AdriTeixeHax/TFG-Brushless-ESC/Figuras Memoria/gateDriveTransformer.tex

\documentclass[tikz]{standalone}
\usepackage{amsmath}
\usepackage{color,pxfonts,fix-cm}
\usepackage{latexsym}
\usepackage{helvet}
\usepackage{lmodern}
\usepackage{fontspec}
\usepackage[T1]{fontenc}
\usepackage[utf8x]{inputenc}
\usepackage{tgpagella}
\usepackage{pict2e}
\usepackage{wasysym}
\usepackage[english]{babel}
\usepackage{tikz}
\usepackage{circuitikz}
\pagestyle{empty}
\usepackage[margin=1in]{geometry}
\usepackage{pgf}
\usepackage{pgfplots}

% Documento
\begin{document}
\begin{circuitikz}
  \draw (2,0) node[transformer core](T){}
      (T.base) node{1:1}
      (T.inner dot A1) node[circ]{}
      (T.inner dot B1) node[circ]{};
  \draw (T.A1) -- ++(-1,0) coordinate(pt1);
  \draw (T.A2) -- ++(-1,0) to[sqV] (pt1);
  \draw (T.B1) to[R, l={$R_{\textit{G}_\textit{S}}$}] ++(1.5,0) -- ++(0.5,0) node[nigfete, solderdot, anchor=G](Q1){\killdepth{$M_\textit{H}$}};
  \draw (Q1.D) -- ++(0,0.25)node[vcc]{\textit{VDD}};
  \draw (T.B2) -- ++(1.75,0) coordinate(pt2);
  \draw (pt2 |- T.A1) to[R, l_={$R_{\textit{G}_\textit{P}}$}] (pt2);
  \node at (pt2 |- T.A1) [circ] {};
  \draw (pt2) -- (pt2 -| Q1.S) coordinate (pt3) -- (Q1.S);
  \node at (pt2) [circ] {};
  \draw (pt3) -- ++(0.25,0) node[vcc, rotate=-90]{\rotatebox{90}{\!\!\!\!\textit{Carga}}};
  \node at (pt2 -| Q1.S) [circ] {};
  \draw (pt3) node[nigfete, solderdot, anchor=D](Q2){$M_\textit{L}$};
  \draw[dashed] (Q2.S) -- ++(0,-0.5);
  \draw[dashed] (Q2.G) -- ++(-0.5,0);
\end{circuitikz}
\end{document}
