AdriTeixeHax/TFG-Brushless-ESC/Figuras Memoria/diseñoGeneralESC.pdf

LDO

+5 V | +3.3 V | +24 V | LDO | +12 V

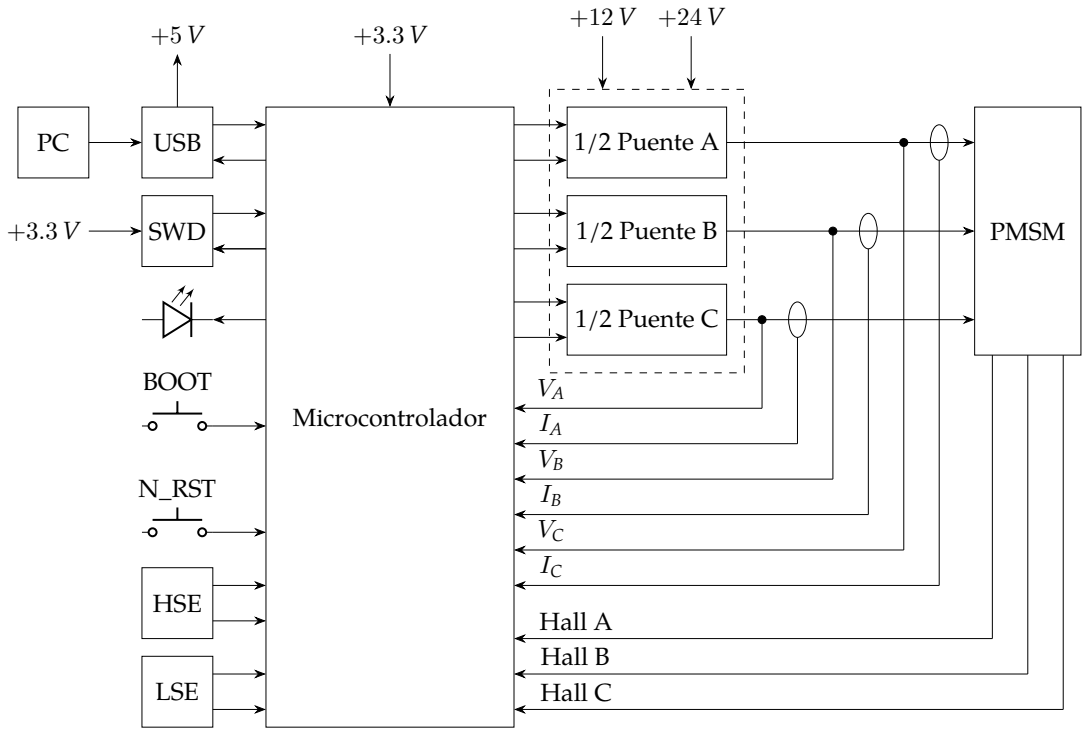
[picture p1: figure]
1/2 Puente A; 1/2 Puente B; 1/2 Puente C; Microcontrolador; Hall A Hall B Hall C; USB; PMSM; HSE; LSE; SWD; BOOT; N_RST
