AdriTeixeHax/TFG-Brushless-ESC/Figuras Memoria/gateDriveTransformer.pdf

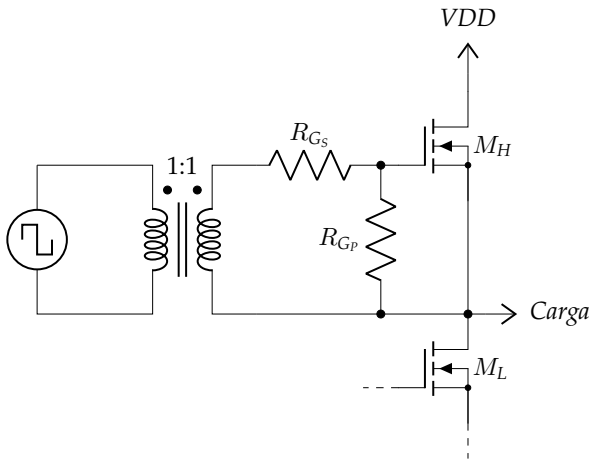
[picture p2: figure]
RGS; VDD; RGP; Carga
