AdriTeixeHax/TFG-Brushless-ESC/Figuras Memoria/insideMOSFET.pdf

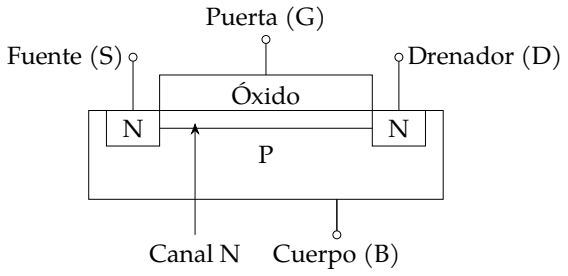
[picture p3: figure]
Óxido; Canal N; Fuente (S); Drenador (D); Puerta (G); Cuerpo (B)

G
S

D
