AdriTeixeHax/TFG-Brushless-ESC/Figuras Memoria/PCBStructure.pdf

Serigrafía inferior

Máscara de soldadura inferior

Cobre inferior

Prepreg (Fibra de vidrio + resina)

Cobre interna 2

Fibra de vidrio (FR4)

Cobre interna 1

Prepreg (Fibra de vidrio + resina)

Cobre superior

Máscara de soldadura superior

Serigrafía superior
