AdriTeixeHax/TFG-Brushless-ESC/Figuras Memoria/phaseEq.pdf

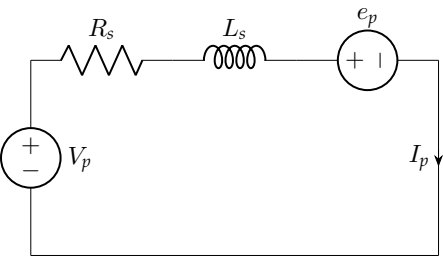
[picture p4: figure]
VpR
