AdriTeixeHax/TFG-Brushless-ESC/Figuras Memoria/boostConverterOperation.tex

\documentclass[tikz]{standalone}
\usepackage{amsmath}
\usepackage{color,pxfonts,fix-cm}
\usepackage{latexsym}
\usepackage{helvet}
\usepackage{lmodern}
\usepackage{fontspec}
\usepackage[T1]{fontenc}
\usepackage[utf8x]{inputenc}
\usepackage{tgpagella}
\usepackage{pict2e}
\usepackage{wasysym}
\usepackage[english]{babel}
\usepackage{tikz}
\usepackage{circuitikz}
\pagestyle{empty}
\usepackage[margin=1in]{geometry}
\usepackage{pgf}
\usepackage{pgfplots}

% Documento
\begin{document}
    \pgfplotsset{yticklabel style={text width=6em,align=right}}
    \centering
    \begin{tikzpicture}[scale=0.9]
        \begin{axis}[
            title={\textit{PWM}},
            grid=major,
            width=10cm,
            height=3.8cm,
            ymin=-0.2, ymax=1.2,
            xmin=0, xmax=10,
            xtick={0,2,4,6,8,10},
            xticklabels={$0$, $DT$, $T$, $T+DT$, $2T$, $2T+DT$},
            ytick={0,1},
            yticklabels={\textit{OFF}, \textit{ON}},
            samples=1000,
            at={(0,0cm)}
        ]
            \addplot [
                domain=0:10,
                samples=1000,
                blue,
            ]
            {
                (x < 2 || (x > 4 && x < 6) || (x > 8 && x < 10)) ? 1 : 0
            };
        \end{axis}
        \begin{axis}[
            title={$v_\textit{L}(t)$},
            grid=major,
            width=10cm,
            height=3.8cm,
            ymin=-7, ymax=12,
            xmin=0, xmax=10,
            xtick={0,2,4,6,8,10},
            xticklabels={$0$, $DT$, $T$, $T+DT$, $2T$, $2T+DT$},
            ytick={-5,0,10},
            yticklabels={$V_{\textit{out}} - V_{\textit{in}}$, $0$, $V_\textit{in}$},
            samples=1000,
            at={(0,-3.75cm)}
        ]
            \addplot [
                domain=0:10,
                samples=1000,
                blue,
            ]
            {
                (x < 2 || (x > 4 && x < 6) || (x > 8 && x < 10)) ? 10 : -5
            };
        \end{axis}
        \begin{axis}[
            title={$i_\textit{L}(t)$},
            grid=major,
            width=10cm,
            height=3.8cm,
            ymin=0, ymax=10,
            xmin=0, xmax=10,
            xtick={0,2,4,6,8,10},
            xticklabels={$0$, $DT$, $T$, $T+DT$, $2T$, $2T+DT$},
            ytick={5,9},
            yticklabels={$I_\textit{in}$, $I_\textit{in} + \Delta i_\textit{L}$},
            at={(0,-7.5cm)}
        ]
        \addplot [color=blue, forget plot]
          table[row sep=crcr]{%
            0	5\\
            2	8.98\\
            4	4.96\\
            6	8.94\\
            8	4.92\\
            10	8.9\\
        };
        \end{axis}
        \begin{axis}[
            title={$i_{\textit{SW}}(t)$},
            grid=major,
            width=10cm,
            height=3.8cm,
            ymin=0, ymax=10,
            xmin=0, xmax=10,
            xtick={0,2,4,6,8,10},
            xticklabels={$0$, $DT$, $T$, $T+DT$, $2T$, $2T+DT$},
            ytick={5,9},
            yticklabels={$I_\textit{SW}$, $I_\textit{SW}^\textit{p}$},
            at={(0,-11.25cm)}
        ]
        \addplot [color=blue, forget plot]
          table[row sep=crcr]{%
            0	5\\
            0.01	5.02\\
            0.02	5.04\\
            0.03	5.06\\
            0.04	5.08\\
            0.05	5.1\\
            0.06	5.12\\
            0.07	5.14\\
            0.08	5.16\\
            0.09	5.18\\
            0.1	5.2\\
            0.11	5.22\\
            0.12	5.23999999999999\\
            0.13	5.25999999999999\\
            0.14	5.27999999999999\\
            0.15	5.29999999999999\\
            0.16	5.31999999999999\\
            0.17	5.33999999999999\\
            0.18	5.35999999999999\\
            0.19	5.37999999999999\\
            0.2	5.39999999999999\\
            0.21	5.41999999999999\\
            0.22	5.43999999999999\\
            0.23	5.45999999999999\\
            0.24	5.47999999999999\\
            0.25	5.49999999999999\\
            0.26	5.51999999999999\\
            0.27	5.53999999999999\\
            0.28	5.55999999999999\\
            0.29	5.57999999999999\\
            0.3	5.59999999999999\\
            0.31	5.61999999999999\\
            0.32	5.63999999999999\\
            0.33	5.65999999999999\\
            0.34	5.67999999999999\\
            0.35	5.69999999999999\\
            0.36	5.71999999999998\\
            0.37	5.73999999999998\\
            0.38	5.75999999999998\\
            0.39	5.77999999999998\\
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
        };
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
                0.25	-1\\
                0.26	-1\\
                0.27	-1\\
                0.28	-1\\
                0.29	-1\\
                0.3	-1\\
                0.31	-1\\
                0.32	-1\\
                0.33	-1\\
                0.34	-1\\
                0.35	-1\\
                0.36	-1\\
                0.37	-1\\
                0.38	-1\\
                0.39	-1\\
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
            };
        \end{axis}
    \end{tikzpicture}%  
\end{document}
