AdriTeixeHax/TFG-Brushless-ESC/Figuras Memoria/boostConverterOperation.pdf

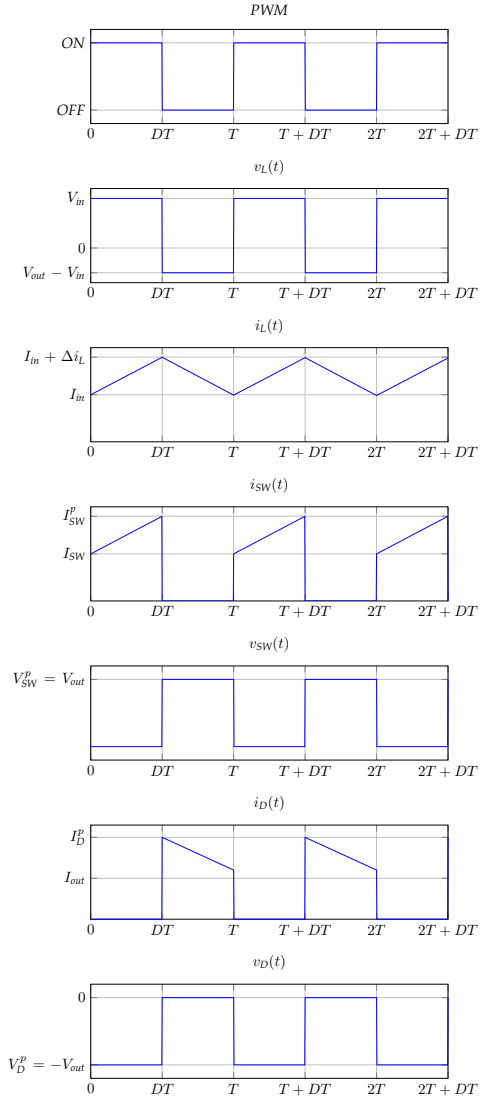
[picture p5: page 1]
OFF; PWM; Vout − Vin; Vin; Iin; Iin + ∆iL; ISW; iSW(t); p SW = Vout; vSW(t); Iout; p D = −Vout
