AdriTeixeHax/TFG-Brushless-ESC/Figuras Memoria/controlledHB.pdf

# VCCCOM

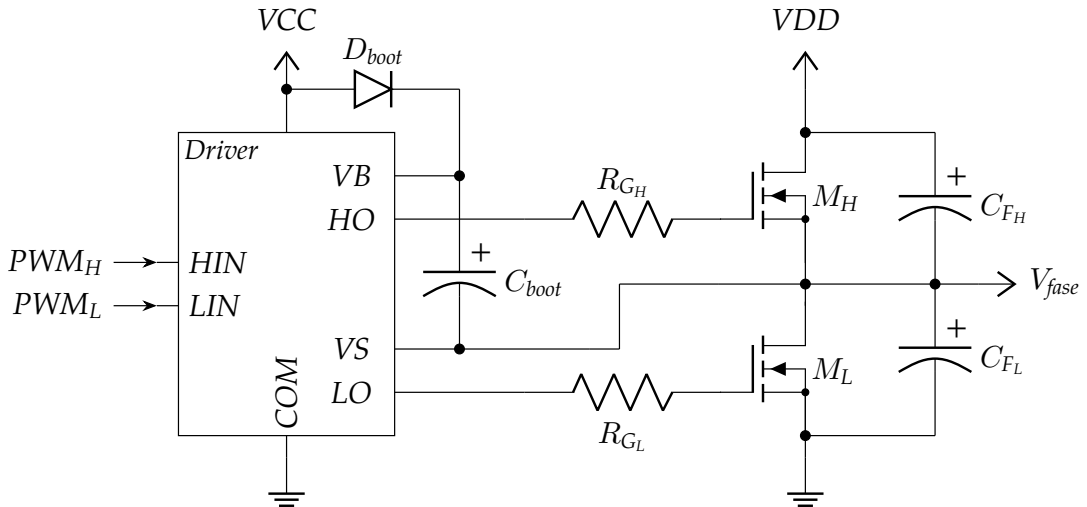
[picture p6: page 1]
Dboot; Cboot; HIN LIN; Vfase; PWM; H PWM; VDD; Driver
