AdriTeixeHax/TFG-Brushless-ESC/Figuras Memoria/curvesMOSFET.pdf

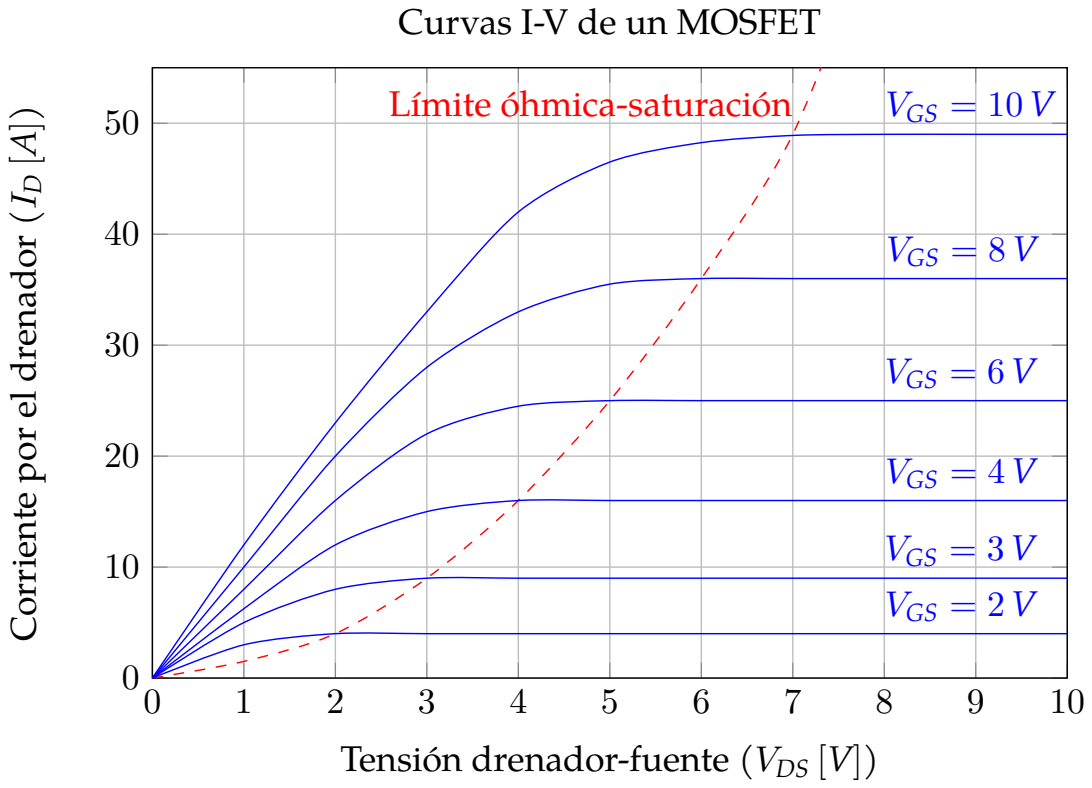
[picture p7: page 1]
Límite óhmica-saturación; VGS =; VDS

Curvas I-V de un MOSFET

Corriente por el drenador (ID [A])

VGS = | 8 V

VGS = | 6 V

VGS = | V 4 3 V

VGS = | 2 V

Tensión drenador-fuente (
