AdriTeixeHax/TFG-Brushless-ESC/Figuras Memoria/boostConverter.pdf

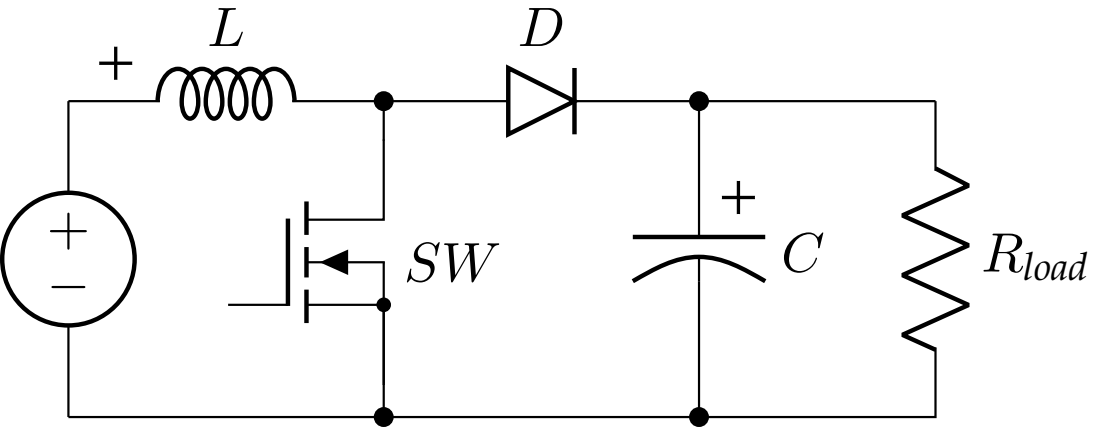
[picture p8: page 1]
Rload
