AdriTeixeHax/TFG-Brushless-ESC/Figuras Memoria/fullBridge.pdf

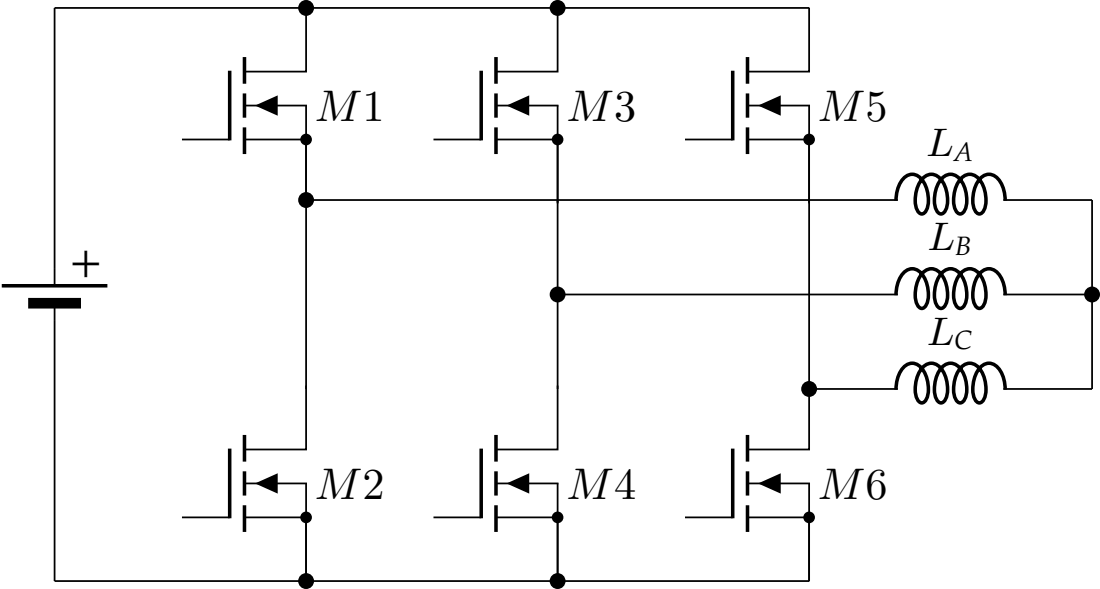
[picture p9: page 1]
