AdriTeixeHax/TFG-Brushless-ESC/Figuras Memoria/ringing.pdf

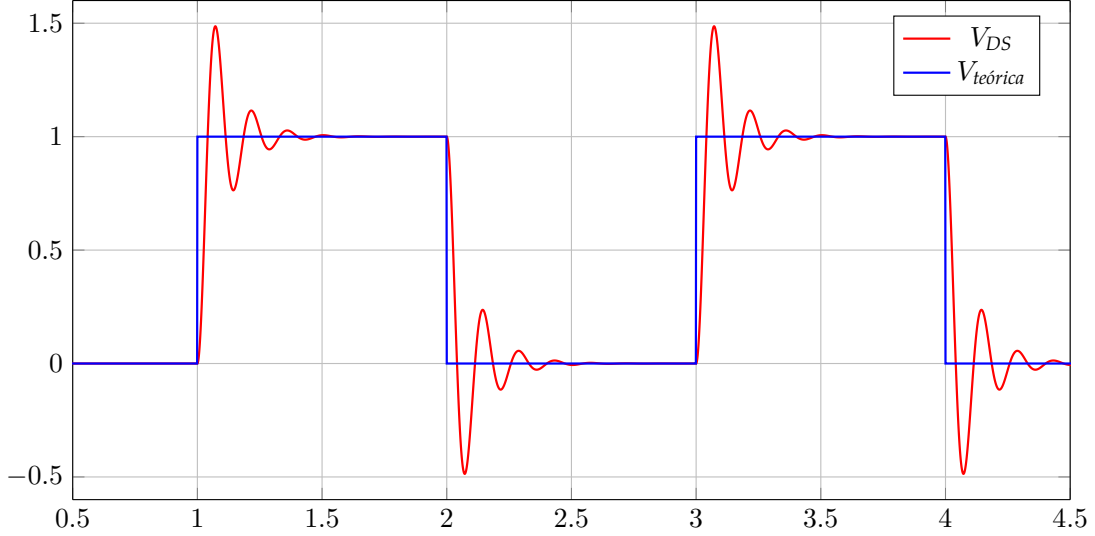
[picture p10: page 1]
VDS Vteórica
