AdriTeixeHax/TFG-Brushless-ESC/simulation/models/LT1160_TA01.asc

C1: cap; 10µ
C2: cap; 1µ
C3: cap; 100µ
D1: diode; 1N4148
Lload: ind; .7m; Rser=.16
Q1: nmos; IRFZ44N
Q2: nmos; IRFZ44N
R1: res; 10K
U1: LT1160
V1: voltage; 12
V2: voltage; PULSE(0 3.3 0; 1n 1n 1u 10u)
V3: voltage; PULSE(0 3.3 5u; 1n 1n 1u 10u)
V4: voltage; 24
Named nets: 0, IN, OUT
.tran 1m startup
LT1160 - Half-/Full-Bridge N-Channel Power MOSFET Drivers
60V Max Supply Referenced DC Motor Half-Bridge Driver
Note:
  If the simulation model is not found please update with the "Sync Release" command from the "Tools" menu.
  It remains the customer's responsibility to verify proper and reliable operation in the actual application.
  Component substitution and printed circuit board layout may significantly affect circuit performance or reliability.
  Contact your local sales representative for assistance. This circuit is distributed to customers only for use with LTC parts.
  Copyright © 2012 Linear Technology Inc. All rights reserved.
