AdriTeixeHax/TFG-Brushless-ESC/TFG-Brushless-ESC/TFG-Brushless-ESC.kicad_pcb

## KiCad design TFG-Brushless-ESC/TFG-Brushless-ESC.kicad_pcb (2025-02-09)

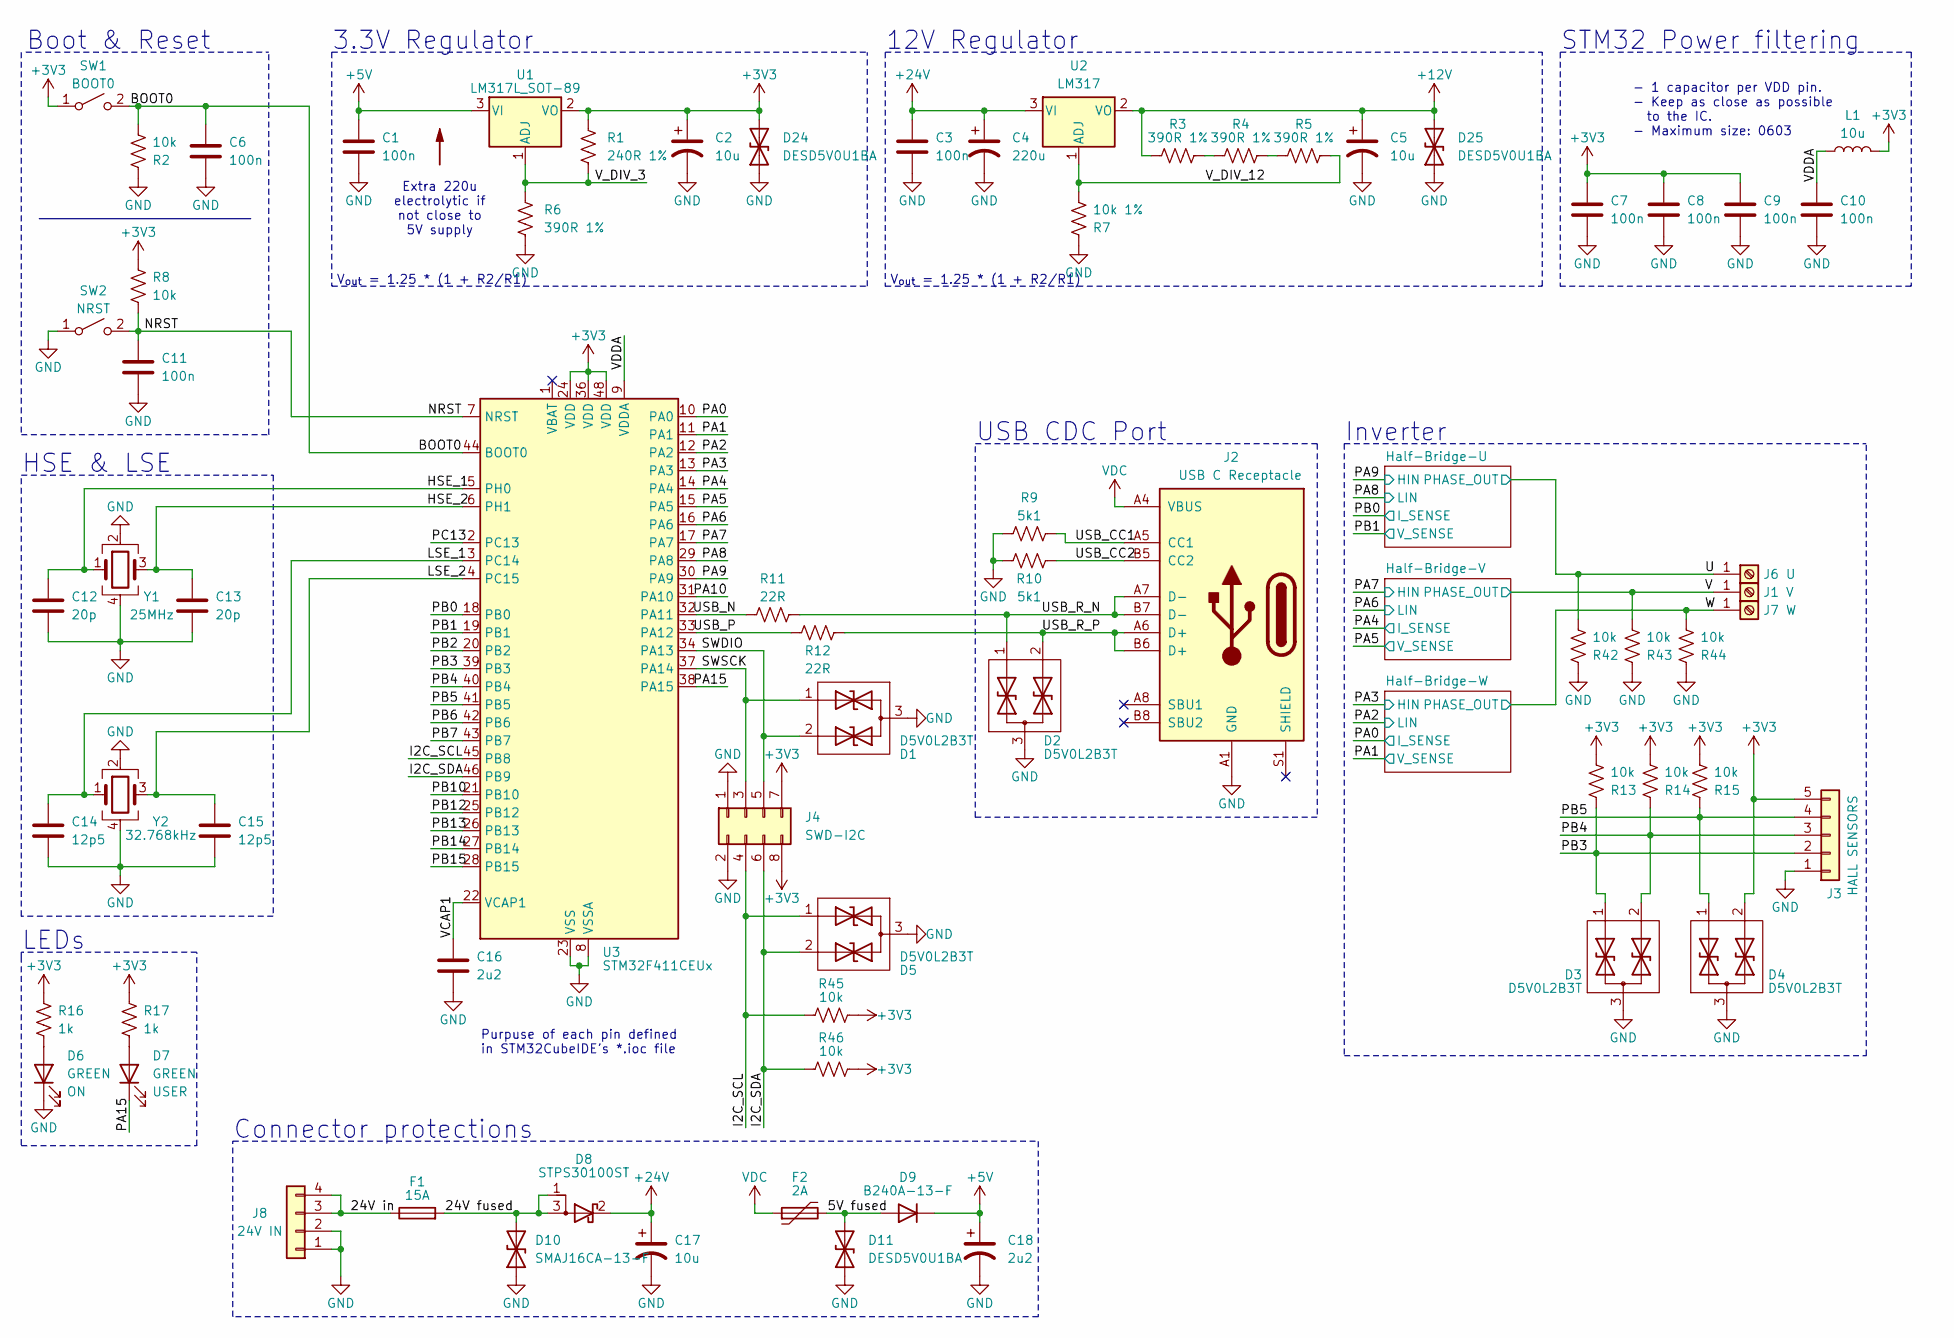
[picture p11: schematic TFG-Brushless-ESC.kicad_sch, RTSpeed]

Parts:
C1, C3, C6, C7, C8, C9, C10, C11: 100n; C_0603_1608Metric
C2, C5, C17: 10u; CP_Elec_4x5.4
C4: 220u; CP_Elec_4x5.4
C12, C13: 20p; C_0603_1608Metric
C14, C15: 12p5; C_0603_1608Metric
C16: 2u2; C_0603_1608Metric
C18: 2u2; CP_Elec_4x5.4
D1, D2, D3, D4, D5: D5V0L2B3T; SOT-523
D6, D7: GREEN; LED_0805_2012Metric
D8: STPS30100ST; TO-220-3_Vertical
D9: B240A-13-F; D_SMA
D10: SMAJ16CA-13-F; D_SMA
D11, D24, D25: DESD5V0U1BA; D_SOD-323_HandSoldering
F1: 15A; Fuseholder_Automotive
F2: 2A; Fuse_1812_4532Metric
J1: V; Screw_Terminal; LCSC part C481447
J2: USB C Receptacle; USB_C_Receptacle_XKB_U262-16XN-4BVC11
J3: HALL SENSORS; JST_PH_S5B-PH-K_1x05_P2.00mm_Horizontal
J4: SWD-I2C; PinHeader_2x04_P2.54mm_Horizontal
J6: U; Screw_Terminal; LCSC part C481447
J7: W; Screw_Terminal; LCSC part C481447
J8: 24V IN; PhoenixContact_MSTBA_2,5_4-G-5,08_1x04_P5.08mm_Horizontal
L1: 10u; L_0805_2012Metric
R1: 240R 1%; R_0603_1608Metric
R2, R8, R13, R14, R15, R42, R43, R44, R45, R46: 10k; R_0603_1608Metric
R3, R4, R5, R6: 390R 1%; R_0603_1608Metric
R7: 10k 1%; R_0603_1608Metric
R9, R10: 5k1; R_0603_1608Metric
R11, R12: 22R; R_0603_1608Metric
R16, R17: 1k; R_0603_1608Metric
SW1: BOOT0; SW_Push_1P1T_NO_6x6mm_H9.5mm
SW2: NRST; SW_Push_1P1T_NO_6x6mm_H9.5mm
U1: LM317L_SOT-89; SOT-89-3
U2: LM317; TO-220-3_Vertical
U3: STM32F411CEUx; QFN-48-1EP_7x7mm_P0.5mm_EP5.6x5.6mm
Y1: 25MHz; Oscillator_SMD_Abracon_ASE-4Pin_3.2x2.5mm
Y2: 32.768kHz; Oscillator_SMD_Abracon_ASE-4Pin_3.2x2.5mm

Connections:
+3V3: C2.1, C7.1, C8.1, C9.1, D4.2, D24.2 (A2), J3.5, J4.7, J4.8, L1.2, R1.1, R8.1, R13.2, R14.2, R15.2, R16.1, R17.1, R45.2, R46.2, SW1.1 (A), U1.2 (VO), U3.24 (VDD), U3.36 (VDD), U3.48 (VDD); also elsewhere on the board
+5V: C1.1, C18.1, D9.1 (K), U1.3 (VI)
+12V: C5.1, D25.2 (A2), R3.1, U2.2 (VO); also elsewhere on the board
+24V: C3.1, C4.1, C17.1, D8.2 (K), U2.3 (VI); also elsewhere on the board
/5V fused: D9.2 (A), D11.2 (A2), F2.2
/24V fused: D8.1 (A), D8.3 (A), D10.2 (A2), F1.2
/24V in: F1.1, J8.3, J8.4; also elsewhere on the board
/BOOT0: C6.2, R2.2, SW1.2 (B), U3.44 (BOOT0)
/HSE_1: C12.1, U3.5 (PH0), Y1.1
/HSE_2: C13.1, U3.6 (PH1), Y1.3
/I2C_SCL: D5.1, J4.4, R45.1, U3.45 (PB8)
/I2C_SDA: D5.2, J4.6, R46.1, U3.46 (PB9)
/LSE_1: C14.1, U3.3 (PC14), Y2.1
/LSE_2: C15.1, U3.4 (PC15), Y2.3
/NRST: C11.2, R8.2, SW2.2 (B), U3.7 (NRST)
/PA0: U3.10 (PA0); also elsewhere on the board
/PA1: U3.11 (PA1); also elsewhere on the board
/PA2: U3.12 (PA2); also elsewhere on the board
/PA3: U3.13 (PA3); also elsewhere on the board
/PA4: U3.14 (PA4); also elsewhere on the board
/PA5: U3.15 (PA5); also elsewhere on the board
/PA6: U3.16 (PA6); also elsewhere on the board
/PA7: U3.17 (PA7); also elsewhere on the board
/PA8: U3.29 (PA8); also elsewhere on the board
/PA9: U3.30 (PA9); also elsewhere on the board
/PA10: U3.31 (PA10)
/PA15: D7.1 (K), U3.38 (PA15)
/PB0: U3.18 (PB0); also elsewhere on the board
/PB1: U3.19 (PB1); also elsewhere on the board
/PB2: U3.20 (PB2)
/PB3: D3.1, J3.2, R13.1, U3.39 (PB3)
/PB4: D3.2, J3.3, R14.1, U3.40 (PB4)
/PB5: D4.1, J3.4, R15.1, U3.41 (PB5)
/PB6: U3.42 (PB6)
/PB7: U3.43 (PB7)
/PB10: U3.21 (PB10)
/PB12: U3.25 (PB12)
/PB13: U3.26 (PB13)
/PB14: U3.27 (PB14)
/PB15: U3.28 (PB15)
/PC13: U3.2 (PC13)
/SWDIO: D1.2, J4.5, U3.34 (PA13)
/SWSCK: D1.1, J4.3, U3.37 (PA14)
/U: J6.1, R42.2; also elsewhere on the board
/USB_CC1: J2.A5 (CC1), R9.2
/USB_CC2: J2.B5 (CC2), R10.2
/USB_N: R11.1, U3.32 (PA11)
/USB_P: R12.1, U3.33 (PA12)
/USB_R_N: D2.1, J2.A7 (D-), J2.B7 (D-), R11.2
/USB_R_P: D2.2, J2.A6 (D+), J2.B6 (D+), R12.2
/V: J1.1, R43.2; also elsewhere on the board
/VCAP1: C16.1, U3.22 (VCAP1)
/VDDA: C10.1, L1.1, U3.9 (VDDA)
/V_DIV_3: R1.2, R6.1, U1.1 (ADJ)
/V_DIV_12: R5.2, R7.2, U2.1 (ADJ)
/W: J7.1, R44.2; also elsewhere on the board
GND: C1.2, C2.2, C3.2, C4.2, C5.2, C6.1, C7.2, C8.2, C9.2, C10.2, C11.1, C12.2, C13.2, C14.2, C15.2, C16.2, C17.2, C18.2, D1.3, D2.3, D3.3, D4.3, D5.3, D6.1 (K), D10.1 (A1), D11.1 (A1), D24.1 (A1), D25.1 (A1), J2.A1 (GND), J2.A12 (GND), J2.B1 (GND), J2.B12 (GND), J3.1, J4.1, J4.2, J8.1, J8.2, R2.1, R6.2, R7.1, R9.1, R10.1, R42.1, R43.1, R44.1, SW2.1 (A), U3.8 (VSSA), U3.23 (VSS), U3.35 (VSS), U3.47 (VSS), U3.49 (VSS), Y1.2, Y1.4, Y2.2, Y2.4; also elsewhere on the board
unnamed: D6.2 (A), R16.2
unnamed: D7.2 (A), R17.2
unnamed: R3.2, R4.1
unnamed: R4.2, R5.1
VDC: F2.1, J2.A4 (VBUS), J2.A9 (VBUS), J2.B4 (VBUS), J2.B9 (VBUS)

Notes on the sheet:
V_{out} = 1.25 * (1 + R2/R1)
Boot & Reset
LEDs
3.3V Regulator
STM32 Power filtering
Connector protections
- 1 capacitor per VDD pin. - Keep as close as possible to the IC. - Maximum size: 0603
Inverter
USB CDC Port
12V Regulator
HSE & LSE
Purpuse of each pin defined in STM32CubeIDE's *.ioc file
Extra 220u electrolytic if not close to 5V supply

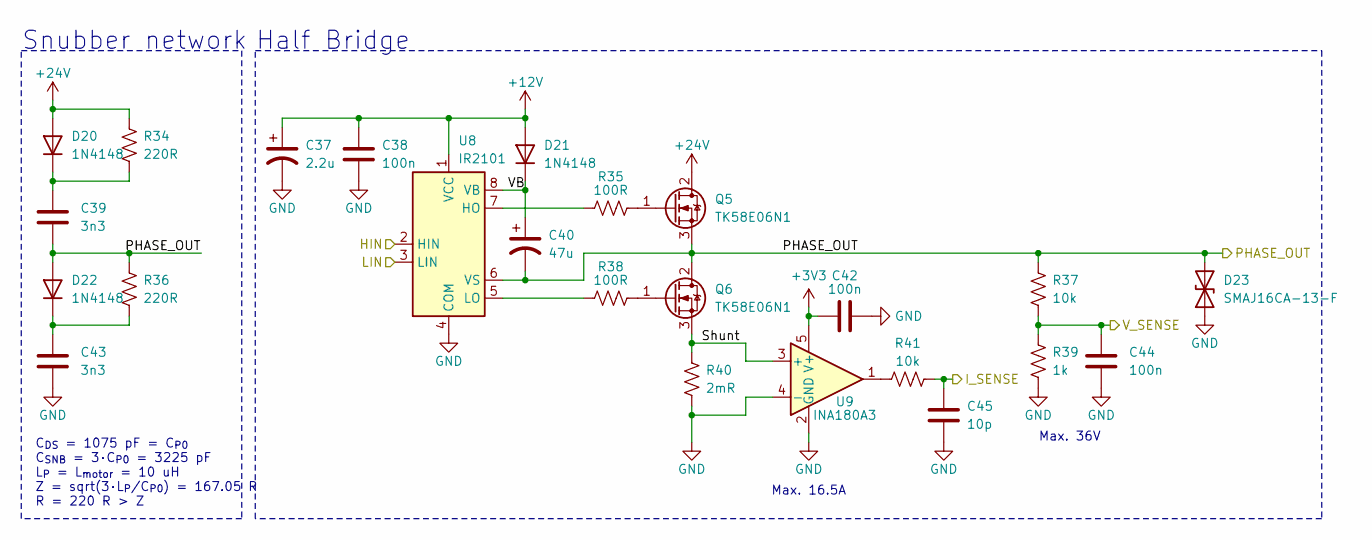
[picture p12: schematic Half-Bridge.kicad_sch, Half Bridge]

Parts:
C37: 2.2u; CP_Elec_4x5.4
C38, C42, C44: 100n; C_0603_1608Metric
C39, C43: 3n3; C_0603_1608Metric
C40: 47u; CP_Elec_4x5.4
C45: 10p; C_0603_1608Metric
D20, D21, D22: 1N4148; D_SOD-123
D23: SMAJ16CA-13-F; D_SMA
Q5, Q6: TK58E06N1; TO-220-3_Vertical
R34, R36: 220R; R_0603_1608Metric
R35, R38: 100R; R_0805_2012Metric
R37, R41: 10k; R_0603_1608Metric
R39: 1k; R_0603_1608Metric
R40: 2mR; R_2512_6332Metric
U8: IR2101; SOIC-8-1EP_3.9x4.9mm_P1.27mm_EP2.29x3mm
U9: INA180A3; SOT-23-5

Connections:
+3V3: C42.1, U9.5 (V+); also elsewhere on the board
+12V: C37.1, C38.1, D21.2 (A), U8.1 (VCC); also elsewhere on the board
+24V: D20.2 (A), Q5.2 (D), R34.2; also elsewhere on the board
/Half-Bridge-W/Shunt: Q6.3 (S), R40.1, U9.3 (+)
/Half-Bridge-W/VB: C40.1, D21.1 (K), U8.8 (VB)
/PA0: C45.2, R41.2; also elsewhere on the board
/PA1: C44.1, R37.1, R39.2; also elsewhere on the board
/PA2: U8.3 (LIN); also elsewhere on the board
/PA3: U8.2 (HIN); also elsewhere on the board
/W: C39.2, C40.2, D22.2 (A), D23.2 (A2), Q5.3 (S), Q6.2 (D), R36.2, R37.2, U8.6 (VS); also elsewhere on the board
GND: C37.2, C38.2, C42.2, C43.2, C44.2, C45.1, D23.1 (A1), R39.1, R40.2, U8.4 (COM), U9.2 (GND), U9.4 (-); also elsewhere on the board
unnamed: C39.1, D20.1 (K), R34.1
unnamed: C43.1, D22.1 (K), R36.1
unnamed: Q5.1 (G), R35.2
unnamed: Q6.1 (G), R38.2
unnamed: R41.1, U9.1
unnamed: R35.1, U8.7 (HO)
unnamed: R38.1, U8.5 (LO)

Parts of its further copies:
C19, C28: 2.2u; CP_Elec_4x5.4
C20, C24, C26, C29, C33, C35: 100n; C_0603_1608Metric
C21, C25, C30, C34: 3n3; C_0603_1608Metric
C22, C31: 47u; CP_Elec_4x5.4
C27, C36: 10p; C_0603_1608Metric
D12, D13, D14, D16, D17, D18: 1N4148; D_SOD-123
D15, D19: SMAJ16CA-13-F; D_SMA
Q1, Q2, Q3, Q4: TK58E06N1; TO-220-3_Vertical
R18, R20, R26, R28: 220R; R_0603_1608Metric
R19, R22, R27, R30: 100R; R_0805_2012Metric
R21, R25, R29, R33: 10k; R_0603_1608Metric
R23, R31: 1k; R_0603_1608Metric
R24, R32: 2mR; R_2512_6332Metric
U4, U6: IR2101; SOIC-8-1EP_3.9x4.9mm_P1.27mm_EP2.29x3mm
U5, U7: INA180A3; SOT-23-5

Connections of its further copies:
+3V3: C24.1, C33.1, U5.5 (V+), U7.5 (V+); also elsewhere on the board
+12V: C19.1, C20.1, C28.1, C29.1, D13.2 (A), D17.2 (A), U4.1 (VCC), U6.1 (VCC); also elsewhere on the board
+24V: D12.2 (A), D16.2 (A), Q1.2 (D), Q3.2 (D), R18.2, R26.2; also elsewhere on the board
/Half-Bridge-U/Shunt: Q2.3 (S), R24.1, U5.3 (+)
/Half-Bridge-U/VB: C22.1, D13.1 (K), U4.8 (VB)
/Half-Bridge-V/Shunt: Q4.3 (S), R32.1, U7.3 (+)
/Half-Bridge-V/VB: C31.1, D17.1 (K), U6.8 (VB)
/PA4: C36.2, R33.2; also elsewhere on the board
/PA5: C35.1, R29.1, R31.2; also elsewhere on the board
/PA6: U6.3 (LIN); also elsewhere on the board
/PA7: U6.2 (HIN); also elsewhere on the board
/PA8: U4.3 (LIN); also elsewhere on the board
/PA9: U4.2 (HIN); also elsewhere on the board
/PB0: C27.2, R25.2; also elsewhere on the board
/PB1: C26.1, R21.1, R23.2; also elsewhere on the board
/U: C21.2, C22.2, D14.2 (A), D15.2 (A2), Q1.3 (S), Q2.2 (D), R20.2, R21.2, U4.6 (VS); also elsewhere on the board
/V: C30.2, C31.2, D18.2 (A), D19.2 (A2), Q3.3 (S), Q4.2 (D), R28.2, R29.2, U6.6 (VS); also elsewhere on the board
GND: C19.2, C20.2, C24.2, C25.2, C26.2, C27.1, C28.2, C29.2, C33.2, C34.2, C35.2, C36.1, D15.1 (A1), D19.1 (A1), R23.1, R24.2, R31.1, R32.2, U4.4 (COM), U5.2 (GND), U5.4 (-), U6.4 (COM), U7.2 (GND), U7.4 (-); also elsewhere on the board
unnamed: C21.1, D12.1 (K), R18.1
unnamed: C25.1, D14.1 (K), R20.1
unnamed: C30.1, D16.1 (K), R26.1
unnamed: C34.1, D18.1 (K), R28.1
unnamed: Q1.1 (G), R19.2
unnamed: Q2.1 (G), R22.2
unnamed: Q3.1 (G), R27.2
unnamed: Q4.1 (G), R30.2
unnamed: R25.1, U5.1
unnamed: R33.1, U7.1
unnamed: R19.1, U4.7 (HO)
unnamed: R22.1, U4.5 (LO)
unnamed: R27.1, U6.7 (HO)
unnamed: R30.1, U6.5 (LO)

Notes on the sheet:
Max. 36V
Half Bridge
C_{DS} = 1075 pF = C_{P0} C_{SNB} = 3·C_{P0} = 3225 pF L_{P} = L_{motor} = 10 uH Z = sqrt(3·L_{P}/C_{P0}) = 167.05 R R = 220 R > Z
Max. 16.5A
Snubber network

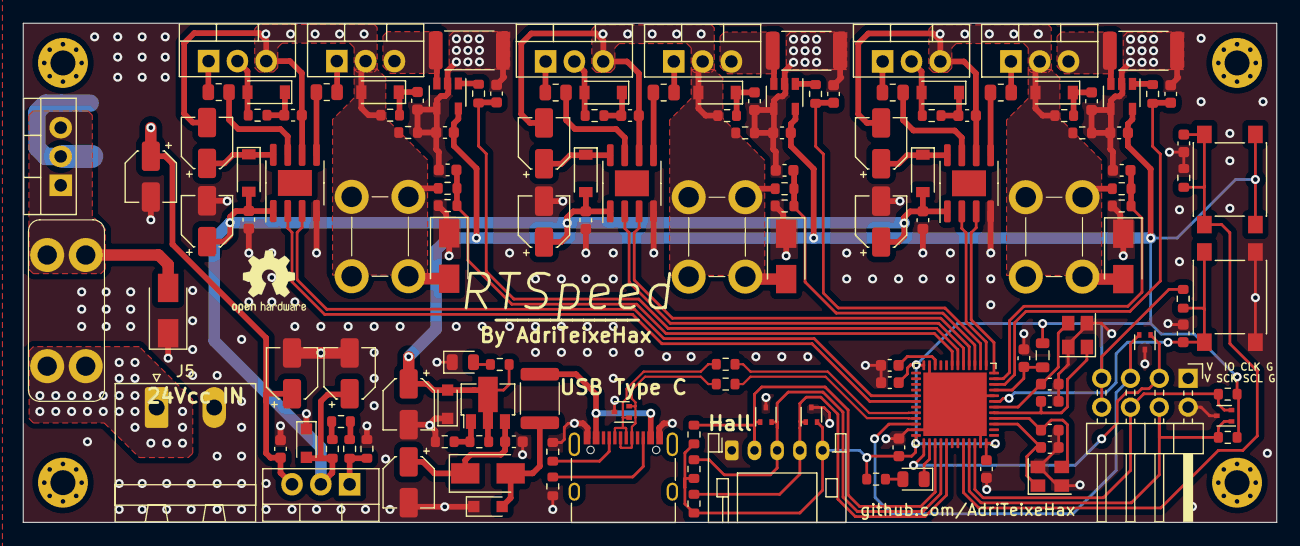
[picture p13: board TFG-Brushless-ESC.kicad_pcb from above]

Board: 4 copper layers, 110.5 x 44.0 mm, 142 parts (0 on the bottom side), 79 nets.

Other parts of the board:
J5: 24V IN; PhoenixContact_MSTBA_2,5_2-G-5,08_1x02_P5.08mm_Horizontal

Their connections:
/24V in: J5.1; also elsewhere on the board
GND: J5.2; also elsewhere on the board
