AdriTeixeHax/TFG-Brushless-ESC/STM32/TFG-Brushless-ESC.ioc

Mcu.UserName=STM32F411CEUx
PA0-WKUP.GPIO_Label=I_SENSE_W
PA0-WKUP.Signal=ADCx_IN0
PA1.GPIO_Label=V_SENSE_W
PA1.Signal=ADCx_IN1
PA11.Signal=USB_OTG_FS_DM
PA12.Signal=USB_OTG_FS_DP
PA13.Signal=SYS_JTMS-SWDIO
PA14.Signal=SYS_JTCK-SWCLK
PA15.GPIO_Label=N_USER_LED
PA15.Signal=GPIO_Output
PA2.GPIO_Label=LO_W
PA2.Signal=S_TIM2_CH3
PA3.GPIO_Label=HI_W
PA3.Signal=S_TIM2_CH4
PA4.GPIO_Label=I_SENSE_V
PA4.Signal=ADCx_IN4
PA5.GPIO_Label=V_SENSE_V
PA5.Signal=ADCx_IN5
PA6.GPIO_Label=LO_V
PA6.Signal=S_TIM3_CH1
PA7.GPIO_Label=HI_V
PA7.Signal=S_TIM3_CH2
PA8.GPIO_Label=LO_U
PA8.Signal=S_TIM1_CH1
PA9.GPIO_Label=HI_U
PA9.Signal=S_TIM1_CH2
PB0.GPIO_Label=I_SENSE_U
PB0.Signal=ADCx_IN8
PB1.GPIO_Label=V_SENSE_U
PB1.Signal=ADCx_IN9
PB3.GPIO_Label=HALL_W
PB3.Signal=GPXTI3
PB4.GPIO_Label=HALL_V
PB4.Signal=GPXTI4
PB5.GPIO_Label=HALL_U
PB5.Signal=GPXTI5
PB8.Signal=I2C1_SCL
PB9.Signal=I2C1_SDA
PC14-OSC32_IN.Signal=RCC_OSC32_IN
PC15-OSC32_OUT.Signal=RCC_OSC32_OUT
