AdriTeixeHax/TFG-Brushless-ESC/(commit log)

2024-02-04 Updated arduino serial timeout
2024-02-10 Half bridge design
    [Half-Bridge.kicad_sch, RTSpeed.kicad_pcb, RTSpeed.kicad_sch]
2024-02-11 Added STM32F411 development schematic
    [Half-Bridge.kicad_sch, RTSpeed.kicad_sch]
2024-02-11 Connected Inverter
    [Half-Bridge.kicad_sch, RTSpeed.kicad_sch]
2024-02-20 updated inverter model
    [Half-Bridge.kicad_sch, RTSpeed.kicad_sch, inverterModel.kicad_pcb, inverterModel.kicad_sch]
2024-04-05 Added some footprints
    [Half-Bridge.kicad_sch, RTSpeed.kicad_sch]
2024-07-10 Changes in half-bridge
    Corrected voltage from 48 to 24V and 5V Vcc to 12V Vcc
    [Half-Bridge.kicad_sch, TFG-Brushless-ESC.kicad_sch]
2024-07-16 Attempt at implementing regenerative braking
    [Half-Bridge.kicad_sch, Regen-breaking.kicad_sch, TFG-Brushless-ESC.kicad_sch]
2024-07-17 Figured out regenerative braking
    [Half-Bridge.kicad_sch]
2024-07-17 Added current and voltage sensing
    Other changes: removed BAT Diode since it will not be used, renamed pins of STM32
    [Half-Bridge.kicad_sch, TFG-Brushless-ESC.kicad_sch]
2024-07-18 Added simple code to test PWM
2024-08-03 STM and Eeschema changes
    STM tests and fixed MOSFET error in Half Bridge
    [Half-Bridge.kicad_sch, Regen-breaking.kicad_sch, TFG-Brushless-ESC.kicad_pcb]
2024-08-07 Footprint corrections
    [Half-Bridge.kicad_sch, TFG-Brushless-ESC.kicad_sch]
2024-08-07 Half bridges done
    [Half-Bridge.kicad_sch, TFG-Brushless-ESC.kicad_pcb, TFG-Brushless-ESC.kicad_sch]
2024-08-08 Switched stackup and routed part of uC
    [TFG-Brushless-ESC.kicad_pcb, TFG-Brushless-ESC.kicad_sch]
2024-09-08 Changes in schematic and pcb
    [TFG-Brushless-ESC.kicad_pcb, TFG-Brushless-ESC.kicad_sch]
2024-09-19 temporary unifinished layout
    tht components and initia layout
    [Half-Bridge.kicad_sch, TFG-Brushless-ESC.kicad_pcb, TFG-Brushless-ESC.kicad_sch]
2024-09-19 cleaned layout
    [TFG-Brushless-ESC.kicad_pcb]
2024-11-25 updated arduino code to send correct testing messages to windows app
    [Testing.ino]
2024-12-23 updated code to match pinout
    [Half-Bridge.kicad_sch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]
2025-01-12 Added pulldown resistors at motor output
    [TFG-Brushless-ESC.kicad_pcb, TFG-Brushless-ESC.kicad_sch]
2025-01-18 Slight code changes
    [Half-Bridge.kicad_sch, TFG-Brushless-ESC.kicad_sch]
2025-02-02 Change motor terminal blocks and new half bridge layaout
    [Half-Bridge.kicad_sch, TFG-Brushless-ESC.kicad_pcb, TFG-Brushless-ESC.kicad_sch]
2025-02-06 PCB v2
    [TFG-Brushless-ESC.kicad_pcb, TFG-Brushless-ESC.kicad_sch]
2025-02-08 PCB v3
    [Half-Bridge.kicad_sch, TFG-Brushless-ESC.kicad_pcb, TFG-Brushless-ESC.kicad_sch]
2025-02-08 updated main power connector to phoenix
    [TFG-Brushless-ESC.kicad_pcb, TFG-Brushless-ESC.kicad_sch]
2025-02-09 renaming images
    [TFG-Brushless-ESC.kicad_sch]
